ISHRAQ6251/Mochi-Rover/PROJECT_STATE.md

# Project State

> **2026-08-28**: Project renamed **MochiRover -> HERO**
> (Hazardous Environment Reconnaissance & Observation robot) per course-project
> requirements. Sketch folder `MochiRover/` -> `HERO/`, `MochiRover.ino` ->
> `HERO.ino`, `mochi_eyes.*` -> `hero_eyes.*`, AP SSID `HERO` / pass
> `hero1234`, mDNS `hero.local`, default access token `hero`, NVS namespace
> `hero`. Rebuild + reflash needed (NVS namespace changed).

## Summary

Wi-Fi controlled RC rover for a university microcontroller lab project. Hardware:
ESP32-S3-CAM module (**cheap bare clone**, N16R8 = 16 MB flash / 8 MB OPI PSRAM,
OV5640 camera on ribbon/FPC), DRV8833 dual H-bridge, 2x N20 DC gear motors
(differential/skid steering), 1.3" I2C SH1106 OLED (addr 0x3C). A smartphone-
oriented web UI (password-gated, default `hero`) provides an MJPEG live stream
with camera start/stop (sensor de-init), forward/back/turn controls with a speed
slider, still/clip capture (browser-side MediaRecorder), a flashlight toggle in
Settings (on-board LED, GPIO2), mood buttons (6 moods), and a message-to-OLED
text box. The OLED runs a state-driven animated "HERO" character face
(boot/connect -> idle -> driving -> mood override -> sleep -> text).

Built from scratch per the project brief; the previous repo (AI Thinker ESP32-CAM
with OV2640) was deleted as instructed and remains in git commit `0cbd870`.

## Finalized Decisions

### Board identity (CONFIRMED by user)

Cheap bare "ESP32-S3 N16R8 CAM" clone with OV5640 — the AliExpress item
`1005007307965550` ("ESP32-S3 N16R8 CAM ... OV3660/5640 Camera"). NOT the
Waveshare AIoT board. Camera pinout cross-confirmed by two independent GitHub
projects that run this exact board: `jzsalinas/exp-esp32s3` and
`sorn-AI/ESP32_WEB_Camera` (both identify it as "Freenove / Generic
ESP32-S3-WROOM-1-N16R8"). Both agree on identical OV5640 wiring.

### Pinout (LOCKED)

| Part | Signal | GPIO |
| ---- | --- | ---- |
| OV5640 | D0..D7 (Y2,Y3,Y4,Y5,Y6,Y7,Y8,Y9) | 11,9,8,10,12,18,17,16 |
| OV5640 | XCLK / PCLK | 15 / 13 |
| OV5640 | VSYNC / HREF | 6 / 7 |
| OV5640 | SIOD / SIOC (SCCB) | 4 / 5 |
| OV5640 | PWDN / RESET | -1 / -1 |
| On-board LED | flash / status | 2 |
| DRV8833 | IN1 / IN2 (motor A) | 47 / 14 |
| DRV8833 | IN3 / IN4 (motor B) | 21 / 42 |
| SH1106 OLED | SDA / SCL (Wire / I2C0, addr 0x3C) | 40 / 41 |
| Reserved | USB D-/D+ (flashing/console) | 19 / 20 |
| Reserved | UART0 TX/RX (header, debug) | 43 / 44 |
| Reserved | BOOT button / strapping | 0 / 3 / 45 / 46 (avoid) |
| Reserved | OPI PSRAM (do not use) | 33-37 |

Camera occupies GPIO 4-18 (except 14). USB 19/20 kept for flashing. All other
module GPIOs free. OLED on Wire / I2C0 (40/41) — GPIO 33-37 are OPI PSRAM on
the N16R8 and must not be used as I2C (that caused TG1WDT_SYS_RST on boot).
Camera SCCB stays on GPIO 4/5 using I2C port 1; sharing Wire1 with the OLED
stole that port and camera probe failed with 0x103.

### Architecture

- Arduino framework, esp32 core v3.x, board profile `esp32:esp32:esp32s3`
  (flash 16 MB QIO 80 MHz, PSRAM OPI 80 MHz).
- Modular .ino/.h/.cpp layout, mirroring the old repo's proven split:
  `config.h`, `settings` (NVS), `motor_control`, `hero_eyes`, `display_manager`,
  `wifi_helper`, `camera_server`, `web_server`, `web_ui/` embedded via generated
  PROGMEM header (`tools/embed_web.py`), `HERO.ino`.
- Web server = Library Manager **ESP Async WebServer** 3.12.1 + **Async TCP**
  3.5.0 (maintainer ESP32Async) for chunked MJPEG. Not the lacamera/ESPHome
  `ESPAsyncWebServer` 3.1.0 listing (that one needs a mbedTLS `_ret` patch).
- OV5640: PIXFORMAT_JPEG, XCLK 20 MHz, fb in PSRAM, fb_count 3, grab LATEST;
  default stream SVGA (800x600), quality from NVS (default 12), all adjustable.
- OLED face drawn procedurally with Adafruit_GFX + SH1106 I2C (no bitmaps).
- USER-CONFIRMED: captures go to the browser (stills via /capture at the live
  stream size, clips recorded client-side via MediaRecorder); no SD dependency.
- USER-CONFIRMED (2026-09-01): AP-only. Always SoftAP `HERO` / `hero1234` at
  192.168.4.1. No station-mode / lab-router provisioning.
- USER-CONFIRMED: default auth password `hero`, changeable from settings modal.
- Settings: flashlight (immediate GPIO2 LED, NVS `flash_on`), theme (browser),
  reverse-left / reverse-right motor, left/right PWM trim 50-100% (NVS
  `trim_l` / `trim_r`), optional new token.
- Drive mixing: firmware `left = throttle + steering`, `right = throttle -
  steering`. The cockpit sends Left as positive steering and Right as negative
  so the physical rover turns the labelled way.
- Camera: stays off at boot (no `esp_camera_init` until `/api/camera` `on=1`).
  Header start/stop POSTs `/api/camera` `on=1/0`. Init/deinit run in
  `cameraServer.update()` from `loop()`, not the async web task. `/api/state`
  `camRunning` is `wanted()`, not the momentary `running()` flag. A mutex
  serializes init/deinit with frame get/return. MJPEG copies JPEG bytes into
  PSRAM then returns the fb immediately (`fb_count` 3).
- MJPEG: one `StreamPacketizer` per `/stream` client. `/api/state` and
  `/api/info` use fixed `snprintf` buffers (heap-free poll path).
- Drive safety: motors stop when controls are released / on disconnect. The
  firmware watchdog coasts the motors ~1.5 s after the last drive/stop command
  (`DRIVE_WATCHDOG_MS`), and the UI repeats the drive command every 300 ms while
  a button is held, so a lost connection or closed tab can never leave the rover
  driving itself.

Behavioral defaults chosen (recorded, not asked): auth password default `hero`
(NVS, changeable from UI); sleep expression after 60 s of no driving input
(SLEEP_TIMEOUT_MS, was 600 s in the old repo — shortened for lab demos); mood
override lasts ~4 s (Wink 1.5 s) then returns to idle; idle blinks every
~1.8-4.3 s; message box persists until cleared; default stream resolution SVGA
800x600.

## Completed

- [x] Read project brief (full content available from git commit `0cbd870`).
- [x] Read every file of the old repository (OV2640-era build) for context.
- [x] Confirmed `PROJECT_STATE.md` did not exist -> treated as new project.
- [x] Deleted all old files per brief (recoverable in git commit `0cbd870`).
- [x] Created this PROJECT_STATE.md.
- [x] User confirmed: AP config portal, browser-download captures, password `hero`.
- [x] User provided web-UI layout (pasted text from screenshots).
- [x] User confirmed board = cheap bare ESP32-S3-CAM clone (not Waveshare AIoT).
- [x] Camera OV5640 pinout locked via two independent GitHub projects
      (jzsalinas/exp-esp32s3 + sorn-AI/ESP32_WEB_Camera) — identical pinout.
- [x] Free-GPIO map derived; motors on 1/14/21/42 (later L_IN1 moved to 47),
      OLED I2C on 40/41, LED on 2.
- [x] Built all firmware modules (config, settings, motor_control, hero_eyes
      6 moods, display_manager, wifi_helper, camera_server, web_server, web_ui,
      embed tool, main sketch).
- [x] Compiles clean with `esp32:esp32:esp32s3:FlashSize=16M,PSRAM=opi`
      (1105 KB / 84% of 1.25 MB app partition).
- [x] LEDC conflict resolved: camera XCLK moved to native-IDF channel 5/timer 2
      (invisible to the Arduino LEDC wrapper); motors pinned to Arduino LEDC
      channels 0-3 on timers 0-1 via `ledcAttachChannel`.
- [x] README.md + FUNCTIONALITY.md written (wiring, build, API, face engine,
      power note about separate motor supply).
- [x] ESPAsyncWebServer 3.1.0 patched for mbedTLS (non-`_ret` MD5 calls);
      note recorded in README for reproducibility.
- [x] **Review pass completed** (found + fixed):
  - Critical: UI POSTs sent no `Content-Type`, so ESPAsyncWebServer 3.x parsed
    `text/plain` bodies and failed its `key=value` detection for single-pair
    bodies -> auth/drive/mood/message/flash/provisioning would all have failed.
    Fixed in `web_ui/app.js` by sending
    `Content-Type: application/x-www-form-urlencoded`.
  - `/capture` no longer copies the full UXGA JPEG into an internal-heap String
    (risk of OOM for large frames); it now streams from the PSRAM frame buffer
    via a chunked filler that returns the buffer when done.
  - Stream packetizer: fixed an off-by-n offset when a frame ends mid-fill and
    the next frame is appended in the same chunk (served bytes were misaligned
    with the absolute stream offset).
  - Provisioning UX: the old flow polled `/api/info` after the AP went away and
    reported "could not reach the network". The UI now detects the AP drop and
    tells the user to join their Wi-Fi and open `hero.local`.
  - Removed unused `_drivingSince` / `_frameLen` / `_frameStart` members; fixed
    stale LEDC channel comment in `motor_control.cpp`.
- [x] Docs restructured: README moved to repo root; comprehensive USER_MANUAL.md
      moved to repo root (parts, wiring, upload via arduino-cli/IDE/esptool,
      usage, troubleshooting); `HERO/README.md` removed.
- [x] Verified: compiles clean (1106618 B / 84%), `node --check` passes on
      `web_ui/app.js`, `web_assets.h` regenerated after the UI fix.
- [x] **Post-rename bug pass (2026-08-28)**: found and fixed the missing drive
      watchdog. `MOTOR_STOP_DELAY_MS` was defined but unused, so nothing ever
      stopped the motors on client disconnect despite the "stop on disconnect"
      claim. Implemented `DRIVE_WATCHDOG_MS` (1.5 s) in `MotorControl::update()`
      and a 300 ms drive keep-alive in `web_ui/app.js`; regenerated
      `web_assets.h`; docs updated (USER_MANUAL, FUNCTIONALITY, README).

- [x] **AP-only + motor reverse (2026-09-01)**: dropped STA/provisioning; the
      rover always advertises SoftAP HERO. Settings can reverse each motor
      independently (NVS `rev_left` / `rev_right`).

- [x] **Stream / capture / cockpit bugs (2026-09-02)**: MJPEG filler no longer
      ends the response on a missed frame (that dropped live view during
      /capture). Snapshot no longer blocks the async server for up to 10 s;
      frame buffers are returned on client disconnect. UI: one poll timer,
      stop motors on hide/pagehide, CTRL lamp reflects poll failure.

- [x] **Motor trim (2026-09-02)**: Settings left/right PWM scale 50-100% so
      unmatched N20s can be calibrated to track straight. Saved in NVS.

- [x] **Cockpit UI pass (2026-09-01)**: CAM lamp now tracks the MJPEG
      connection (onload only fired on the first frame, so the dot went red
      while video kept playing). Emoji replaced with SVG because PROGMEM `\x`
      escapes ate following hex digits. Portrait layout: video fills leftover
      height with `object-fit: contain` (4:3 sensor), cross d-pad, mood/speed
      beside it. `/capture` no longer switches to UXGA (that reused SVGA
      buffers and produced a half-garbage JPEG).

- [x] **OLED garbage fix (2026-09-01)**: `drawBitmap()` onto the SH1106 only
      OR'd white pixels and never cleared the panel RAM, so frames smeared into
      unreadable garbage on the 128x64. Draw directly into the SH1106 buffer,
      `clearDisplay()` each frame, cap refresh at ~25 Hz.

- [x] **Boot WDT fix (2026-09-01)**: OLED I2C moved off GPIO 35/36 (OPI PSRAM)
      SPIIO6/SPIIO7 on N16R8) to GPIO 40/41. Missing OLED is probed via I2C
      ACK and skipped instead of hanging. `Serial.begin(115200)` plus boot
      breadcrumbs added so the USB monitor shows sketch logs, not only the ROM
      dump. Motors do not need to be wired for the face / web UI to run.

- [x] **Motor reverse fix (2026-09-11)**: one motor would not reverse. The
      Arduino core maps LEDC `channel` to `timer = (channel / 2) % 4`, so the
      old motor channels `1-4` put the fourth input (GPIO42) on timer 2 - the
      same timer the camera XCLK uses (`LEDC_CHANNEL_5` / `LEDC_TIMER_2`).
      Motors were moved to channels `0-3` (timers 0-1) so timer 2 stays
      exclusive to the camera. This removed a real latent timer conflict, but
      turned out **not** to be the cause of the missing direction (see below).
- [x] **Motor polarity default (2026-09-11)**: on this build both motors are
      wired with opposite polarity, so `reverseLeft` / `reverseRight` now
      default to `true` in `settings.h` (forward works on a fresh NVS with no
      UI changes). Runtime values still come from NVS; erase NVS / Settings
      reset to pick up the new default.
- [x] **LEDC channel move verified (2026-09-11)**: pulled the arduino-esp32
      3.0.7 `esp32-hal-ledc.c` source to confirm `timer = (channel / 2) % 4`.
      Channels `0-3` map to timers 0/1, so the motor set no longer touches the
      camera's timer 2. This removes a latent conflict but did **not** fix the
      user's symptom, so it is not the root cause.
- [x] **Serial-free motor pin test (2026-09-11)**: the user cannot use the USB
      serial monitor on battery (serial drops when the pack is connected), so a
      WiFi test was added instead. `GET /api/pintest?token=hero&pin=N&speed=200`
      drives exactly one motor input for `MOTOR_TEST_MS` (0.6 s) and returns the
      PWM `duty` read back from the pin, isolating firmware/attach failures
      (`duty=0`) from wiring/DRV8833 faults (`duty=200`, no wheel motion).
- [x] **Faulty DRV8833 identified (2026-09-11)**: the WiFi `/api/pintest` was
      run on pins 0-3; pin 0 (`L_IN1`) produced no wheel movement while pins
      1-3 (GPIO14/21/42) did. The left motor's IN1 wire was moved from GPIO1 to
      the free header pin **GPIO47** (`PIN_MOTOR_L_IN1 47`) to rule out the
      ESP32 pin, but the symptom persisted. Swapping the two left-channel input
      wires showed the dead path follows the **DRV8833 AIN1/OUT1 half-bridge**,
      not the ESP32 GPIO - so GPIO1 was exonerated and the driver is faulty.
      The user is replacing the DRV8833. The code keeps `L_IN1` on GPIO47 (the
      pin validated during bring-up and already wired); GPIO1 is now unused.
      If GPIO47 is not broken out on a given board, use GPIO38/39/48 instead.

- [x] **Library Manager audit (2026-09-13)**: every firmware dependency is
      installable from the Arduino IDE Library Manager (or bundled with the
      Espressif `esp32:esp32` core). No zip / git clone. Board package URL is
      only the standard Espressif one. Switched the async stack from the
      lacamera/ESPHome **ESPAsyncWebServer** 3.1.0 + dvarrel **AsyncTCP** 1.1.4
      pair (which required a local mbedTLS `_ret` patch) to the ESP32Async
      listings **ESP Async WebServer** 3.12.1 + **Async TCP** 3.5.0, which
      already use `MD5Builder` — the README/USER_MANUAL patch note is
      **removed**. Adafruit GFX 1.12.6 / SH110X 2.1.15 / BusIO 1.17.4 were
      already the Library Manager latest and were left pinned. Core 3.3.11
      (latest) still bundles `esp32-camera` plus Preferences, WiFi, DNSServer,
      ESPmDNS, Wire. Rebuild with
      `esp32:esp32:esp32s3:FlashSize=16M,PSRAM=opi` succeeded (1124266 B /
      85% flash, 60908 B / 18% RAM). Pins, NVS keys, AP credentials and REST
      contract unchanged.

      | Library | Was | Library Manager? | Listing / maintainer | Latest | Action |
      | ------- | --- | ---------------- | -------------------- | ------ | ------ |
      | esp32 Arduino core | 3.x | Boards Manager (Espressif URL) | esp32 by Espressif Systems | 3.3.11 | pinned 3.3.11; already latest |
      | ESPAsyncWebServer | 3.1.0 lacamera | yes, but wrong listing | **ESPAsyncWebServer** / lacamera (ESPHome) | 3.1.0 | replaced — mbedTLS `_ret` broken on core 3.3.x |
      | ESP Async WebServer | (not used) | yes | **ESP Async WebServer** / ESP32Async | 3.12.1 | upgraded to this; mbedTLS patch not needed |
      | AsyncTCP | 1.1.4 dvarrel | yes, but wrong listing | **AsyncTCP** / dvarrel | 1.1.4 | replaced (pairing for the old server fork) |
      | Async TCP | (not used) | yes | **Async TCP** / ESP32Async | 3.5.0 | installed as the 3.12.1 server dependency |
      | Adafruit GFX Library | 1.12.6 | yes | **Adafruit GFX Library** / Adafruit | 1.12.6 | left as-is (already latest) |
      | Adafruit SH110X | 2.1.15 | yes | **Adafruit SH110X** / Adafruit | 2.1.15 | left as-is (already latest) |
      | Adafruit BusIO | 1.17.4 | yes | **Adafruit BusIO** / Adafruit | 1.17.4 | left as-is (already latest) |
      | esp32-camera | bundled | n/a (core precompiled libs) | espressif__esp32-camera in esp32s3-libs 3.3.11 | bundled | left as-is; no separate install |
      | Preferences / WiFi / DNSServer / ESPmDNS / Wire | bundled | n/a (core `libraries/`) | Espressif | bundled with 3.3.11 | left as-is |

- [x] **Cockpit camera + turn + portrait (2026-09-25)**: UI left/right
      steering signs swapped so Left turns left (firmware mix unchanged).
       Settings button is a gear SVG (no emoji). Header camera start/stop
       POSTs `/api/camera` `on=0/1`; Stop de-inits the OV5640 after streams
       and snapshots release buffers; Start re-inits from `loop()`.
       `/stream` stays open with multipart whitespace
       while the sensor is re-initing so Start does not 503. Flashlight moved
      out of the cramped portrait header into Settings as an immediate
      checkbox; top bar is camera + mood + gear.

- [x] **Drive pad layout, camera-off boot, stream robustness (2026-09-26)**:
      Cockpit 3-column grid: Mood/Speed spans top-left two thirds, Up is
      top-right, Left/Right/Down share the second row so Down sits under Up
      (no flex-wrap). Camera stays off at boot; UI default is
       "Camera stopped". Stream path memcpy-batches MJPEG segments, copies
       JPEG out of the DMA fb into PSRAM (realloc never holds a live fb),
       uses 3 frame buffers, and mutexes init/deinit vs fb_get. `/capture`
       uses the same copy path. Motor LEDC + watchdog share a mutex; NVS cam
       res/quality are clamped; `/api/state` and `/api/info` copy off the
       stack into a String; UI drive POSTs are single-flight so stop cannot
       lose a race to a stale drive.

## In Progress

- None. Rebuild + reflash needed for firmware/UI on device.

## Open Questions For The User

- None blocking. (Pin choices are the implementer's per the brief; documented in
  `config.h` and final docs. If the user's board differs from the Freenove-style
  clone pinout, camera pins 4/5/6/7/8/9/10/11/12/13/15/16/17/18 are the items to
  double-check against their board's silkscreen/listing.)

## Known Issues / TODO

- OV5640 ribbon wiring on a new board must be verified at build time; the
  pinout above is the well-known Freenove/generic N16R8 layout, but cheap clones
  occasionally relabel. Firmware prints the detected sensor PID on boot so
  mismatches are easy to diagnose.
- Flashlight toggles the on-board LED on GPIO2 (per sorn-AI repo); if a board
  lacks an LED there, wire an external LED to GPIO2 through a resistor.
- Separate motor supply (2x 18650 / 4x AA ~ 6 V) recommended; never draw motor
  current from the ESP32 regulator.
- Older iOS Safari often shows only the first MJPEG frame; Chrome is the
  supported live-view browser.
