ISHRAQ6251/Mochi-Rover/USER_MANUAL.md

# HERO - User Manual

A step-by-step guide for building, uploading and driving your HERO.

---

## 1. What you need

### Electronics

| Item | Notes |
| ---- | ----- |
| ESP32-S3-CAM board (N16R8 clone) | 16 MB flash, 8 MB PSRAM, **OV5640** camera |
| DRV8833 motor driver module | dual H-bridge, 2.7-10.8 V |
| 2x DC gear motors (N20 or TT) | one per side |
| 2x wheels + castor/ball wheel | differential (skid) steering |
| SH1106 1.3" OLED 128x64 | I2C, address 0x3C |
| Battery pack for motors | e.g. 2x 18650 or 4x AA (about 6 V) |
| Power for the ESP32 | USB phone-charging bank / 5 V regulator |
| Jumper wires | for motor driver + OLED |
| Optional: external LED + resistor | only if your board has no onboard LED on GPIO2 |

### Software

- [arduino-cli](https://arduino.github.io/arduino-cli/) (recommended) **or** the
  Arduino IDE 2.x with the ESP32 board package.
- USB data cable for the ESP32-S3-CAM.

---

## 2. Software setup (one time)

### 2.1 Install arduino-cli (Linux/macOS/Windows)

```bash
curl -fsSL https://raw.githubusercontent.com/arduino/arduino-cli/master/install.sh | sh
export PATH="$HOME/.local/bin:$PATH"    # add to your shell profile
```

or install the latest release from the [releases page](https://github.com/arduino/arduino-cli/releases).

### 2.2 Add the ESP32 core

```bash
arduino-cli config init
arduino-cli config add board_manager.additional_urls \
  https://espressif.github.io/arduino-esp32/package_esp32_index.json
arduino-cli core update-index
arduino-cli core install esp32:esp32@3.3.11
```

This installs the Arduino ESP32 core (v3.3.11 or later 3.x). The core already
bundles the precompiled `esp32-camera` driver plus Preferences, WiFi, DNSServer,
ESPmDNS and Wire, so you do not need to install those separately.

### 2.3 Install the libraries

All of these are in the Arduino IDE Library Manager (Sketch > Include Library >
Manage Libraries). Use the **exact listing names** below — several similarly
named forks exist and will not compile against the current ESP32 core.

```bash
arduino-cli lib install "ESP Async WebServer@3.12.1" "Async TCP@3.5.0" \
  "Adafruit GFX Library@1.12.6" "Adafruit SH110X@2.1.15" "Adafruit BusIO@1.17.4"
```

| Library Manager name | Maintainer | Version |
| --- | --- | --- |
| ESP Async WebServer | ESP32Async | 3.12.1 |
| Async TCP | ESP32Async | 3.5.0 |
| Adafruit GFX Library | Adafruit | 1.12.6 |
| Adafruit SH110X | Adafruit | 2.1.15 |
| Adafruit BusIO | Adafruit | 1.17.4 |

Do **not** install **ESPAsyncWebServer** (lacamera / ESPHome) or **AsyncTCP**
(dvarrel). Those older listings call removed mbedTLS `*_ret` symbols and fail
to compile on esp32 core 3.3.x. The ESP32Async pair already uses `MD5Builder`,
so no local library patch is required.

### 2.4 Compile the sketch

```bash
arduino-cli compile --fqbn esp32:esp32:esp32s3:FlashSize=16M,PSRAM=opi HERO
```

`FlashSize=16M` and `PSRAM=opi` are important - the N16R8 board needs both.
You should see a report similar to:
```
Sketch uses ~1.1 MB (about 85%) of program storage space.
Global variables use ~60 KB (about 18%) of dynamic memory.
```

Exact sizes shift slightly when the web UI is re-embedded. If you edited
`HERO/web_ui/`, regenerate the PROGMEM header first:

```bash
python3 HERO/tools/embed_web.py HERO/web_ui HERO/web_assets.h
```

### 2.5 Alternative: build with the Arduino IDE

If you prefer the Arduino IDE over the command line:

1. Install the **Arduino IDE 2.x**.
2. In **File > Preferences**, set the "Additional boards manager URLs" to
   `https://espressif.github.io/arduino-esp32/package_esp32_index.json` (add it
   if the field is empty).
3. In **Boards Manager** (Tools > Board > Boards Manager), search for
   **esp32** by Espressif and install it.
4. In **Library Manager**, install these exact listings (search the names
   with spaces as written): **ESP Async WebServer** (ESP32Async, 3.12.1) and
   **Async TCP** (ESP32Async, 3.5.0), plus **Adafruit GFX Library** (1.12.6),
   **Adafruit SH110X** (2.1.15), **Adafruit BusIO** (1.17.4). Skip the
   similarly named **ESPAsyncWebServer** / **AsyncTCP** entries.
5. Open `HERO/HERO.ino`. It auto-loads the other files in the
   folder.
6. **Tools > Board > esp32 > ESP32S3 Dev Module**, then set:
   - **Flash Size**: `16MB (128Mb)`
   - **PSRAM**: `OPI PSRAM`
   - **USB CDC On Boot**: `Enabled` (optional; lets you see serial logs)
7. **Sketch > Export Compiled Binary**, or select your port and click
   **Upload** (see section 4 for boot mode).

---

## 3. Wiring

Work from this table. GPIO numbers refer to the silkscreen/labels on the
ESP32-S3-CAM module header pins.

| From (ESP32-S3-CAM) | GPIO | To |
| --- | ---- | -- |
| Camera ribbon | - | Already attached via FPC socket (no user wiring) |
| IN1 | 47 | DRV8833 **AIN1** |
| IN2 | 14 | DRV8833 **AIN2** |
| IN3 | 21 | DRV8833 **BIN1** |
| IN4 | 42 | DRV8833 **BIN2** |
| DRV8833 **AO1/AO2** | - | Left motor terminals |
| DRV8833 **BO1/BO2** | - | Right motor terminals |
| DRV8833 **VM** | - | Motor battery **+** |
| DRV8833 **VIN** | - | 3.3 V (logic supply) |
| GND | - | Common ground (all boards) |
| OLED **SDA** | 40 | SH1106 SDA |
| OLED **SCL** | 41 | SH1106 SCL |
| OLED **VCC** | - | 3.3 V |
| OLED **GND** | - | GND |
| Flash LED (onboard) | 2 | already wired; otherwise an external LED + resistor to GND |

### Wiring checklist

1. **Camera** - seat the OV5640 FPC ribbon into the socket on the ESP32-S3-CAM
   board, gold contacts facing the board. No header pins are needed for it.
2. **DRV8833 inputs** - four jumper wires from the ESP32 GPIOs to the driver's
   four IN pins.
3. **Motors** - connect each motor's two terminals to one driver channel
   (AO1/AO2 for the left motor, BO1/BO2 for the right). Swapping a motor's two
   wires reverses its direction - fix steering direction by swapping if needed.
4. **Motor power** - battery pack to **VM** and **GND**. Connect the same GND
   rail to the ESP32 GND (a common ground is required).
5. **OLED** - 4 wires (VCC, GND, SDA, SCL) from GPIO 40/41. Motors and the
   DRV8833 are not required for the face or the web UI to come up.
6. **Driver logic supply** - DRV8833 `VIN` to 3.3 V; tie `nSLEEP` and `VMODE`
   to 3.3 V as well (enables the driver, full motor voltage).

### Power

- The ESP32 is powered over **USB** (flash it, then run it from a USB power
  bank) or from a regulated 5 V.
- The motors run from a **separate battery pack** (2x 18650 or 4x AA = ~6 V)
  into the DRV8833 `VM` pin.
- Never draw motor current from the ESP32's regulator, and always keep the
  grounds common.

### Avoid these pins

GPIO 19/20 (USB), GPIO 43/44 (UART serial debug), GPIO 0 (BOOT button),
strapping pins GPIO 3/45/46, and **GPIO 33-37** (OPI PSRAM on the N16R8 —
using 35/36 for the OLED watchdog-resets the chip). The camera already
occupies GPIO 4-18 (except 14).

---

## 4. Uploading the code

### 4.1 Put the board in download mode

1. Connect the board to your computer with a **USB data** cable (many cheap
   cables are charge-only - if upload hangs, try another cable).
2. Hold the **BOOT** button on the board.
3. While holding BOOT, tap **RST** and release BOOT.
4. The board stays in download mode until it is reset or powered off.

The board exposes a native USB-Serial/JTAG interface, so it usually appears as
`/dev/ttyACM0` or `/dev/ttyUSB0` (Linux/macOS) or a COM port (Windows).

Find it with:

```bash
arduino-cli board list
```

### 4.2 Upload

```bash
arduino-cli upload -p /dev/ttyACM0 \
  --fqbn esp32:esp32:esp32s3:FlashSize=16M,PSRAM=opi HERO
```

Replace `/dev/ttyACM0` with the port from the previous step.

You should see the progress bar run and finish with "Hard resetting...". The
rover then boots. **First boot after flashing is slow** (the SoftAP, camera and
web server all start up) - give it ~30 seconds, then join the `HERO` network.

**If upload hangs at "Connecting...":** the board is not in download mode (BOOT
was not held). Try again, or check the cable. Some boards with USB-C sockets
need the BOOT sequence *after* plugging in power.

### 4.3 Verify the firmware is running

After upload, open a serial monitor to see the boot log:

```bash
# arduino-cli
arduino-cli monitor -p /dev/ttyACM0 --config baudrate=115200
```

You should see `HERO boot`, then `settings ok` / `motors ok` / `oled ok` (or
`oled missing`), `wifi ...`, `camera ok` (or a camera error) and `HERO ready`.
If you only ever see the ROM dump (`ESP-ROM:esp32s3-...` / `rst:0x8
(TG1WDT_SYS_RST)`) the chip is crashing before the sketch prints — reflash with
`FlashSize=16M,PSRAM=opi` and confirm the OLED is on GPIO 40/41, not 35/36.
If you instead see a camera PID other than OV5640, check the `CAM_*` pins in
`config.h`. Enable **USB CDC On Boot** in the board options so USB serial
works after reset.

### 4.4 Alternative: upload with the Arduino IDE

With the board set up as in section 2.5 and in download mode, select the port
under **Tools > Port**, then click the **Upload** button (right arrow). Watch
the console at the bottom of the IDE for the progress and result.

### 4.5 Alternative: upload with esptool.py

`esptool.py` is included with the ESP32 core. Compile first, then flash the
built binary with a single command:

```bash
# find the built binary
ls HERO/build/*/HERO.ino.bin

# flash (merge puts the app at the right 0x10000 offset with the correct flash size)
python3 -m esptool --chip esp32s3 --port /dev/ttyACM0 \
  --baud 921600 write_flash 0x0 HERO/build/*/HERO.ino.merged.bin
```

Using the `.merged.bin` (if the core produces one) sets the correct bootloader,
partition table and app offsets automatically. Otherwise use `esptool merge_bin`
or let the IDE/arduino-cli handle offsets.

---

## 5. Using the rover

### 5.1 Connect to the rover

The rover is its own Wi-Fi hotspot. No lab router, no SSID/password setup.

1. Power the rover.
2. On your phone, join the Wi-Fi network **`HERO`** (password **`hero1234`**).
   A captive-portal window may open by itself.
3. Open `http://192.168.4.1` in a browser (or wait for the captive page).
4. Unlock with the access token (default **`hero`**).

Stay on the HERO network while you drive. Your phone will not have internet
until you leave that hotspot.

### 5.2 Opening the control page

While joined to **HERO**, open `http://192.168.4.1`. The OLED also shows that
address plus the hotspot password. Change the access token later in Settings.

### 5.3 The control page (cockpit)

- **Top bar** - the "HERO" logo, a status pill (CTRL = phone talking to the
  rover, CAM = live video), then three icons: camera start-stop, mood, and
  settings (gear SVG). Flashlight is not in the header so the gear stays
  tappable on a portrait phone.
- **Camera button** - the sensor is **off** at boot (panel shows "Camera
  stopped", no spinner). Tap the camera icon to **start the sensor** (the
  rover inits the OV5640 from `loop()`, then the picture connects). Tap again
  to **stop the sensor** (de-init, not just the browser picture). Stopping
  also ends a clip if one is recording.
- **Video panel** - live stream, letterboxed to the camera aspect so nothing
  is cropped. Overlay: flip/refresh, photo, record (turns into a stop square
  while recording; a red REC badge shows; tap again to finish). Flip and
  capture are disabled while the camera is stopped.
- **Drive pad** - Mood and Speed span the top-left two thirds; the Up button
  is top-right (same column as Down); Left, Right and Down sit in a row
  underneath. Combine directions to drive
  in arcs, e.g. hold Up and Left together. Left and right turn the physical
  rover that way. Every command is acknowledged by the rover (the OLED shows
  driving-reaction eyes).
- **Drive safety watchdog** - while you hold a button the app re-sends the drive
  command every 300 ms. If the connection drops, the browser tab is closed, or
  the app is killed, the rover receives no more commands and stops the motors on
  its own after ~1.5 s. You never need to "find" a stuck rover that is driving
  itself.
- **Message to OLED** - type text and tap **Send**; the message appears on the
  rover's OLED. Tap the clear button to restore the face.
- **Mood** - header popup or the dropdown: Happy, Angry, Curious, Dead, Sleepy,
  Wink. The face shows the mood for about 4 seconds, then returns to idle.
- **Speed** - slider from 0 to 255; controls how fast the motors run. Start low
  on a bench and raise it once you can control the rover.

### 5.4 What the OLED shows

- **Boot screen** - "HERO / Booting..." with a progress bar.
- **Connection screen** - `AP: 192.168.4.1` and the hotspot password.
- **The face** - the little robot with animated blinking eyes and idle
  behaviour. While sleeping it shows closed eyes with floating "Zzz".
- **Message box** - when you send a message it replaces the big face; the eyes
  shrink to a small strip above the message.
- **Driving** - the eyes react to throttle/steering.
- **Sleep** - after 60 seconds without any input the face "falls asleep" (Zzz);
  any drive/mood/message command wakes it.

### 5.5 Photos and clips

- **Photo** - a still is captured at the live stream resolution (800x600 by
  default) and downloads as `hero_<timestamp>.jpg`. The camera must be running.
- **Clip** - recording is done on your phone's browser (WebM), so no SD card is
  needed. It downloads as `hero_clip.webm` when you stop recording. The stream
  must be live (green CAM dot). Stopping the camera also stops the recording.

### 5.6 Settings

Open the gear in the top bar. On a portrait phone the gear is the right-most
icon (camera, mood, then gear).

- **Flashlight** - checkbox for the on-board LED. Takes effect immediately;
  you do not need to tap Save. The rover remembers the last state.
- **Theme** - dark / light. Stored in the browser, not on the rover.
- **Reverse left / right motor** - flip a channel in software if a motor
  (or the whole rover) drives the wrong way. Saved on the rover when you tap
  Save. Fresh NVS defaults both reverse flags to on (this chassis is wired
  inverted).
- **Left / right trim** - scale that motor's PWM (50-100%) if one N20 is
  faster than the other. Lower the faster side until forward tracks straight.
  Saved on the rover.
- **Change access token** - pick a new login password (min 4 characters). Write
  it down - it is stored on the rover.

### 5.7 Hotspot reminder

The rover always advertises **HERO**. If you cannot see it, power-cycle the
board and wait a few seconds, then scan for Wi-Fi again.

---

## 6. Troubleshooting

| Symptom | Fix |
| --- | --- |
| Upload hangs / "no device found" | Use a **data** USB cable; put the board in download mode (BOOT + tap RST); try another USB port |
| Blank OLED + serial only shows `ESP-ROM` / `TG1WDT_SYS_RST` | Watchdog reset: OLED must be on GPIO **40/41**, never 35/36 (those are PSRAM). Reflash, tap RST. Motors do not need to be wired. |
| Serial shows `I2C bus id(1) has already been acquired` / `sccb init err` | Camera SCCB and the OLED must not share I2C port 1. Reflash this build (OLED on Wire / I2C0, camera on I2C1) |
| OLED stays blank but serial prints `oled missing` | Check VCC=3.3 V, GND, SDA=40, SCL=41; some panels use I2C address 0x3D (the firmware tries both) |
| OLED lights but text/face is smeared or unreadable | Reflash this build - frames are now drawn straight to the 128x64 SH1106 (the old canvas blit never cleared the panel) |
| Serial monitor empty after `HERO boot` should appear | Enable **USB CDC On Boot**; 115200 baud; tap RST after opening the monitor |
| No image in the video panel, CAM dot red | Check the camera ribbon is seated; verify GPIO settings match your board; try reducing XCLK to 10 MHz (see camera_server.cpp). If the overlay says "Camera stopped", tap the camera icon in the top bar to start the sensor |
| Camera button does nothing / stream 503 | Wait a second after Start - the OV5640 re-inits in the Arduino loop, not instantly. Reflash if Stop only blanks the picture but the sensor stays warm (this build de-inits it) |
| Settings gear missing or unreachable in portrait | Flashlight was moved out of the header into Settings. Top bar is camera, mood, gear. Reflash this build |
| Flashlight not in the top bar | Open Settings (gear) and use the **On-board LED** checkbox; it toggles immediately |
| Motors do not spin | Check DRV8833 power (VM/GND), `nSLEEP` tied to 3.3 V, and IN wires; try 100 on the speed slider |
| One motor spins backwards | Settings > Reverse left/right motor (or swap that motor's two wires) |
| A wheel turns one way but **never** the other (e.g. reverse and one turn only move the other wheel) | One motor input is not switching. Test each input over Wi-Fi without the serial monitor: open `http://192.168.4.1/api/pintest?token=hero&pin=0&speed=200` in the phone browser and cycle `pin` = 0,1,2,3. `pin` maps to 0=L_IN1/GPIO47, 1=L_IN2/GPIO14, 2=R_IN3/GPIO21, 3=R_IN4/GPIO42. Each call nudges one wheel for ~0.6 s and replies with the PWM `duty` read back from the pin. `duty:0` means the pin never attached in firmware (reflash / pin conflict); `duty:200` but no motion means a bad jumper, DRV8833 channel, or GPIO. |
| Above test shows an input that never switches | First swap the two input wires of that motor channel at the DRV8833 (e.g. AIN1/AIN2) and re-test. If the dead direction follows the driver input rather than the ESP32 pin, the DRV8833 half-bridge is faulty - replace the driver. If instead the fault follows the ESP32 pin, move that one IN wire to a free header GPIO and update the matching `PIN_MOTOR_*` in `config.h`. Recommended free pins: **GPIO47** (alt GPIO38/39/48). Avoid GPIO0/3 (strapping), 19/20 (USB), 26-37 (flash/OPI PSRAM), 43/44 (UART) and 45/46 (strapping). On this build the test first pointed at `L_IN1`, but the wire-swap proved GPIO1 was fine and the DRV8833 was faulty; `L_IN1` was left on GPIO47 (`PIN_MOTOR_L_IN1 47`). |
| Motors spin but the rover turns the wrong way | This build maps Left to a left turn and Right to a right turn in the UI. If it is still wrong, reverse both motors in Settings, or swap left/right channels (AO/BO) |
| Rover drifts left/right when going straight | Settings > lower Left/Right trim on the faster motor until it tracks straight |
| Can't find the rover Wi-Fi | Stay near the board, wait ~10 s after power-on, join **HERO** / **hero1234** |
| Lost the access token | Reflash the firmware to restore the default token `hero` |
| Flickering / purple video | Lower camera XCLK from 20 MHz to 10 MHz in `camera_server.cpp` |
| Face shows "AP: 192.168.4.1" | Normal - join **HERO** and open that address |
| Video freezes briefly, CAM dot red, then recovers | The stream drops and auto-reconnects after ~2.5 s - normal if the camera is busy capturing a photo; avoid tapping photo while driving |
| Live view frozen / static frame on iPhone Safari | Older iOS Safari renders only the first MJPEG frame; use Chrome on Android or install Chrome on the iPhone |
| CAM dot turns red while the picture is still moving | Reflash this build - the CAM lamp now stays green for the life of the MJPEG connection, not just the first frame |
| Icons show as garbage / boxes | Reflash this build - the UI uses SVG icons instead of emoji |
| Photo is only valid in the top half, rest is garbage | Reflash this build - capture stays at stream resolution instead of jumping to UXGA |
| Motors keep running after closing the app / phone disconnects | The firmware's drive watchdog coasts the motors ~1.5 s after the last drive command, so an unreachable app can never drive the rover on its own. Ensure you flashed the latest build (older builds lacked the watchdog) |
| All buttons do nothing after logging in | The POST requests were not decoded by the server - make sure you flashed the current `web_assets.h` / `app.js` build (the UI must send `Content-Type: application/x-www-form-urlencoded`)
