ISHRAQ6251/Mochi-Rover/HERO/wifi_helper.cpp

#include "wifi_helper.h"
#include "config.h"
#include <ESPmDNS.h>

WifiHelper wifiHelper;

void WifiHelper::begin() {
    WiFi.mode(WIFI_AP);
    WiFi.setHostname(HOSTNAME);
    WiFi.softAP(AP_SSID, AP_PASS);
    delay(200);

    _dns.setErrorReplyCode(DNSReplyCode::NoError);
    _dns.start(53, "*", WiFi.softAPIP());

    if (MDNS.begin(HOSTNAME)) {
        MDNS.addService("http", "tcp", HTTP_PORT);
    }
}

void WifiHelper::update() {
    _dns.processNextRequest();
}

void WifiHelper::ip(char* dst, size_t len) const {
    if (!dst || len == 0) return;
    IPAddress addr = WiFi.softAPIP();
    snprintf(dst, len, "%u.%u.%u.%u", addr[0], addr[1], addr[2], addr[3]);
}
