ISHRAQ6251/Mochi-Rover/HERO/wifi_helper.h

#pragma once

#include <Arduino.h>
#include <DNSServer.h>
#include <WiFi.h>

// Always runs as its own hotspot (SoftAP). The phone joins HERO / hero1234
// and opens http://192.168.4.1 - no lab router, no provisioning.
class WifiHelper {
public:
    void begin();
    void update();          // captive DNS so phones auto-open the cockpit

    // Writes the SoftAP address (e.g. "192.168.4.1") into dst. Avoids the heap
    // allocation of a String on paths polled by every connected client.
    void ip(char* dst, size_t len) const;

private:
    DNSServer _dns;
};

extern WifiHelper wifiHelper;
