ISHRAQ6251/Mochi-Rover/(commit log)

2026-08-06 feat: ESP32-CAM MochiRover - smart rover firmware
    - MJPEG live video stream + snapshot (OV2640)
    - Authenticated responsive web cockpit (drive pads, speed slider with
    haptics, 12 moods, persistent message-to-OLED with Clear button,
    flashlight/animation toggles, settings modal, dark/light theme)
    - Procedural Dasai-Mochi-style OLED face: autonomous idle behavior
    script (gaze, blinks, happy/curious/surprise/suspicious/doze/wink),
    driving-reactive expressions, sleep with Zzz, strict screen priority
    - DRV8833 differential drive via LEDC PWM, NVS settings, Wi-Fi config
    portal with captive DNS, mDNS
    - Compiles clean with arduino-cli esp32:esp32:esp32cam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
2026-08-21 feat: ESP32-S3 OV5640 MochiRover (Wi-Fi web control + OLED face) Co-authored-by: monkeycode-ai <monkeycode-ai@chaitin.com>
2026-08-25 docs: add user manual for wiring, upload and rover usage Co-authored-by: monkeycode-ai <monkeycode-ai@chaitin.com>
2026-08-28 fix: POST content-type, capture memory, stream offsets; docs to repo root Co-authored-by: monkeycode-ai <monkeycode-ai@chaitin.com>
    [MochiRover.ino, camera_server.cpp, mochi_eyes.h, motor_control.cpp]
2026-08-28 feat: rebrand to HERO + add course project proposal docx
    Rename MochiRover to HERO (Hazardous Environment Reconnaissance &
    Observation robot) across firmware, web UI, docs, WiFi SSID/pass,
    mDNS, access token and NVS namespace. Add Project_Proposal_HERO.docx
    covering the required course submission format (group table, title/
    description, features, equipment list, design considerations,
    workflow, timeline) with placeholders for circuit diagram and 3D
    render.
2026-08-29 fix: add drive safety watchdog (stop on client disconnect)
    MOTOR_STOP_DELAY_MS was defined but never used, so nothing stopped the
    motors if the app disconnected while driving, contradicting the
    documented 'stop on disconnect' safety behaviour.
    Firmware: MotorControl now records the last drive/stop command time and
    update() coasts the motors when no command arrives within
    DRIVE_WATCHDOG_MS (1.5 s).
    UI: while a steering/throttle button is held the app re-sends the drive
    command every 300 ms, acting as a keep-alive for the watchdog.
    Docs updated (README, USER_MANUAL, FUNCTIONALITY, PROJECT_STATE).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
    [config.h, motor_control.cpp, motor_control.h]
2026-09-01 fix: move OLED I2C off PSRAM pins to stop boot WDT
    GPIO 35/36 are OPI PSRAM on the N16R8; using them for the SH1106 caused
    TG1WDT_SYS_RST and a blank display. OLED is now on GPIO 40/41, missing
    panels are skipped after an I2C probe, and Serial boot logs were added.
    [HERO.ino, camera_server.cpp, config.h, display_manager.cpp, display_manager.h]
2026-09-01 fix: stop double-init of OLED I2C bus on ESP32
    Adafruit_SH1106G::begin() already starts Wire1. A prior Wire1.begin()
    logged "I2C bus id(1) has already been acquired" and left the display
    dead even though Wi-Fi came up. Let the driver own the bus, probe 0x3C
    then 0x3D, and skip the panel if neither ACKs.
    [display_manager.cpp]
2026-09-01 fix: put OLED on I2C0 so camera SCCB can use I2C1
    Wire1 and the OV5640 sccb-ng driver both claimed I2C port 1, which logged
    "bus already acquired", failed camera probe 0x103, and left the display
    blank. OLED now uses Arduino Wire (port 0); camera SCCB is pinned to port 1.
    [HERO.ino, camera_server.cpp, config.h, display_manager.cpp, display_manager.h]
2026-09-01 fix: draw OLED frames directly so the 128x64 stays readable
    drawBitmap() onto the SH1106 only OR'd white pixels and never cleared
    panel RAM, so successive frames smeared into garbage. Render into the
    SH1106 buffer, clearDisplay() each frame, and cap refresh at ~25 Hz.
    [display_manager.cpp, display_manager.h]
2026-09-01 fix: portrait cockpit, CAM lamp, icons, and half-garbage photos
    CAM stayed red because MJPEG only fires img.onload on the first frame.
    Emoji became garbage in PROGMEM (\xHH ate following hex). Capture no
    longer jumps to UXGA into SVGA buffers. Portrait layout: video fills
    leftover height with object-fit contain, cross d-pad, SVG icons.
    [camera_server.cpp, web_server.cpp]
2026-09-01 feat: AP-only hotspot and persistable motor reverse
    Always run SoftAP HERO/hero1234 at 192.168.4.1 with no STA provisioning.
    Settings can reverse each motor independently and store the flags in NVS.
    [HERO.ino, config.h, display_manager.cpp, motor_control.cpp, settings.cpp, settings.h, web_server.cpp]
2026-09-02 fix: stream/capture leaks, drive stop on hide, and motor trim
    Keep MJPEG alive on a missed frame, return camera buffers on disconnect,
    and stop motors when the tab hides. Settings can now reverse and trim each
    N20 independently so unmatched motors track straight.
    [camera_server.cpp, config.h, display_manager.cpp, hero_eyes.cpp, motor_control.cpp, motor_control.h, settings.cpp, settings.h]
2026-09-10 Enhance camera initialization with logging and retries
    Added logging improvements and retry mechanism for camera initialization.
2026-09-10 Implement motor test API endpoint
    Added a motor test endpoint for diagnostic purposes.
2026-09-10 Remove motor test API endpoint
    Removed the motor test API endpoint and related comments from the web server code.
2026-09-10 Simplify camera initialization process
    Removed unnecessary logging configuration and retry logic for camera initialization.
2026-09-11 fix(motor): diagnose dead left-motor direction, add WiFi pin test
    - Move motor LEDC to channels 0-3 so timer 2 stays dedicated to the camera XCLK
    - Add MotorControl::testPin() and /api/pintest to drive one motor input and
    read the PWM duty back over WiFi (USB serial drops on battery)
    - Route the serial bring-up test through testPin()
    - Move L_IN1 from GPIO1 to GPIO47; a wire-swap proved the fault was the DRV8833
    AIN1 half-bridge (driver replaced), not the ESP32 pin
    - Default reverseLeft/reverseRight to true for this build's inverted wiring
    - Update USER_MANUAL, FUNCTIONALITY and PROJECT_STATE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
    [HERO.ino, camera_server.cpp, config.h, motor_control.cpp, motor_control.h, settings.h, web_server.cpp]
2026-09-14 refactor: multi-client MJPEG, heap-free poll paths, library audit
    - camera_server: one StreamPacketizer per /stream client (shared_ptr
    co-owned by filler + disconnect hook) so a second viewer no longer
    corrupts the shared cursor or drops in-flight frame buffers
    - web_server: build /api/state and /api/info with snprintf into fixed
    buffers; removes heap String churn on every client poll
    - wifi_helper: ip(char*, len) instead of returning a heap String
    - display_manager: drop unused _connected/_apMode/_mood; render AP_SSID,
    AP_PASS and the live SoftAP IP
    - settings: keep the Preferences handle open (writes commit immediately);
    remove unused setCamera/setMotorReverse setters
    - docs: pin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
    [HERO.ino, camera_server.cpp, display_manager.cpp, display_manager.h, settings.cpp, settings.h, web_server.cpp]
2026-09-25 feat: camera start/stop, portrait settings, turn mapping, docs
    Stop de-inits the OV5640 from loop(); Start re-inits it. Flashlight is an
    immediate Settings toggle so the gear stays tappable in portrait. UI left/right
    steering signs match the physical rover. Docs (README, USER_MANUAL,
    FUNCTIONALITY, PROJECT_STATE) now describe the working cockpit and API.
2026-09-26 feat: 3-col drive pad, camera-off boot, stream/mutex robustness
    Cockpit CSS grid matches the portrait layout (Mood/Speed spanning two
    columns, Up above Down). Camera stays off until an explicit Start.
    MJPEG copies JPEG out of the DMA fb before realloc/TCP; capture uses
    the same path. Motor accessors and pin-test share the LEDC mutex.
